adafruit/Adafruit-Circuit-Playground-Tri-Color-E-Ink-Gizmo-PCB/Circuit Playground Tri-color E-Ink Gizmo.brd

## EAGLE design Circuit Playground Tri-color E-Ink Gizmo.brd (2019-11-20)

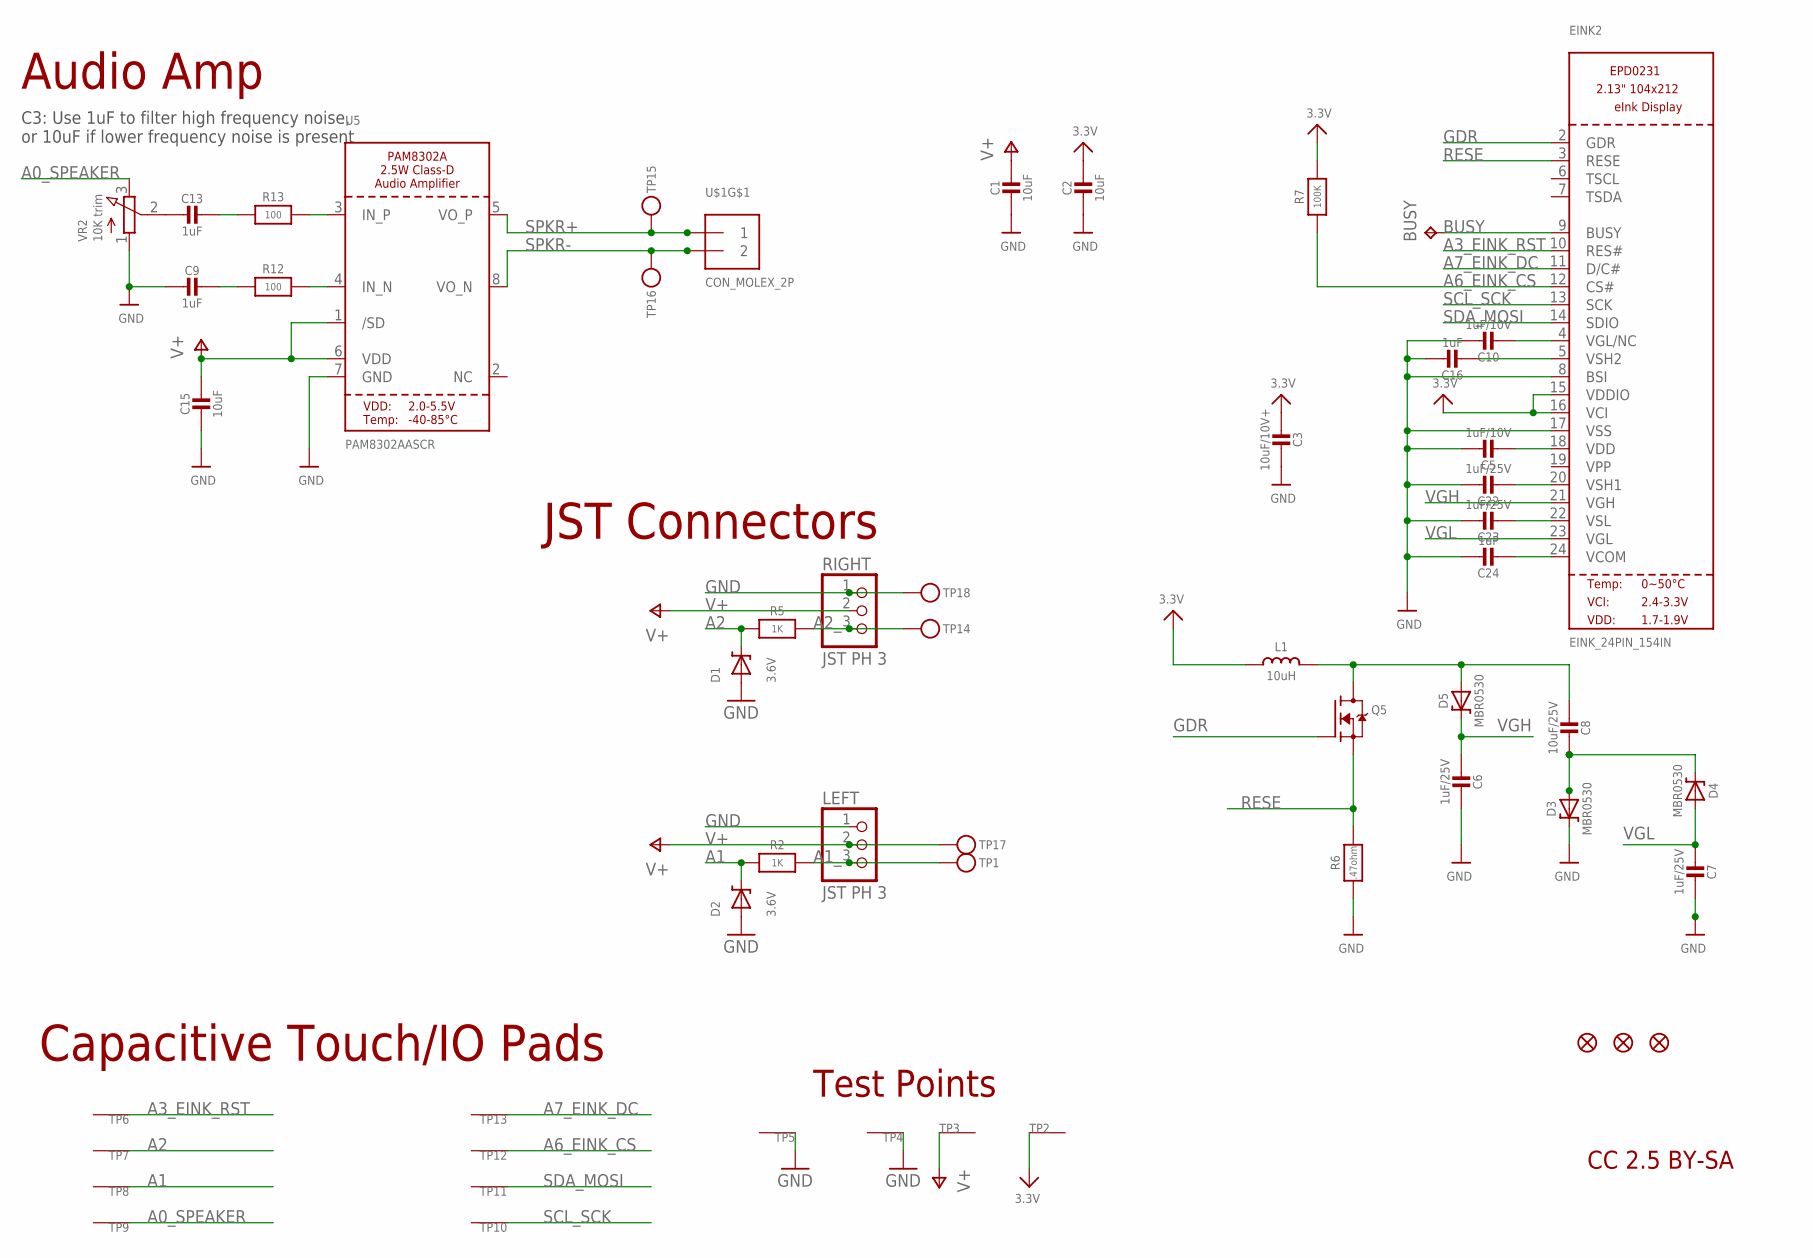
[picture p2: schematic Circuit Playground Tri-color E-Ink Gizmo.sch]

Parts:
BUSY: TPTP15SQ; TP15SQ
C1, C2, C15: 10uF; 0805-NO
C3: 10uF/10V+; 0805-NO
C5, C10: 1uF/10V; 0805-NO
C6, C7, C22, C23: 1uF/25V; 0805-NO
C8: 10uF/25V; 0805-NO
C9, C13, C16, C24: 1uF; 0805-NO
D1, D2: 3.6V; SOD-323
D3, D4, D5: MBR0530; SOD-123
EINK2: EINK_24PIN_154IN; EINK_154IN
L1: 10uH; INDUCTOR_4X4MM_NR401
LEFT: JST PH 3; JSTPH3
Q5: IRLML0100; SOT23-3
R2, R5: 1K; 0603-NO
R6: .47ohm; 0805_10MGAP
R7: 100K; 0603-NO
R12, R13: 100; 0603-NO
RIGHT: JST PH 3; JSTPH3
TP1, TP14, TP15, TP16, TP17, TP18: TESTPOINTROUND1.5MMNO; TESTPOINT_ROUND_1.5MM_NO
TP2, TP3, TP4, TP5, TP6, TP7, TP8, TP9, TP10, TP11, TP12, TP13: SEWTAP_SMTNUTM3; SMT_NUT_3MM
U5: PAM8302AASCR; MSOP8_0.65MM
U$1: CON_MOLEX_2P; 53398-0271
U$2, U$3, U$6: FIDUCIAL_1MM
VR2: 10K trim; TRIMPOT_BOURNS_3303W

Connections:
3.3V: C2.1, C3.2, EINK2.15 (VDDIO), EINK2.16 (VCI), L1.P$2 (2), R7.2, TP2.P$1
A0_SPEAKER: TP9.P$1, VR2.3 (E)
A1: D2.C, R2.2, TP8.P$1
A1_: LEFT.3, R2.1, TP1.P$1
A2: D1.C, R5.2, TP7.P$1
A2_: R5.1, RIGHT.3, TP14.P$1
A3_EINK_RST: EINK2.10 (RES#), TP6.P$1
A6_EINK_CS: EINK2.12 (CS#), R7.1, TP12.P$1
A7_EINK_DC: EINK2.11 (D/C#), TP13.P$1
BUSY: BUSY.TP, EINK2.9 (BUSY)
GDR: EINK2.2 (GDR), Q5.1 (G)
GND: C1.2, C2.2, C3.1, C5.1, C6.2, C7.2, C9.2, C10.1, C15.2, C16.1, C22.1, C23.1, C24.1, D1.A, D2.A, D3.C, EINK2.8 (BSI), EINK2.17 (VSS), LEFT.1, R6.2, RIGHT.1, TP4.P$1, TP5.P$1, TP18.P$1, U5.7 (GND), VR2.1 (A)
unnamed: C8.2, D3.A, D4.C
unnamed: C8.1, D5.A, L1.P$1 (1), Q5.3 (D)
unnamed: C16.2, EINK2.5 (VSH2)
unnamed: C5.2, EINK2.18 (VDD)
unnamed: C22.2, EINK2.20 (VSH1)
unnamed: C10.2, EINK2.4 (VGL/NC)
unnamed: R12.2, U5.4 (IN_N)
unnamed: R13.2, U5.3 (IN_P)
unnamed: C9.1, R12.1
unnamed: C13.1, R13.1
unnamed: C13.2, VR2.2 (S)
unnamed: C23.2, EINK2.22 (VSL)
unnamed: C24.2, EINK2.24 (VCOM)
RESE: EINK2.3 (RESE), Q5.2 (S), R6.1
SCL_SCK: EINK2.13 (SCK), TP10.P$1
SDA_MOSI: EINK2.14 (SDIO), TP11.P$1
SPKR+: TP15.P$1, U5.5 (VO_P), U$1.1
SPKR-: TP16.P$1, U5.8 (VO_N), U$1.2
V+: C1.1, C15.1, LEFT.2, RIGHT.2, TP3.P$1, TP17.P$1, U5.1 (/SD), U5.6 (VDD)
VGH: C6.1, D5.C, EINK2.21 (VGH)
VGL: C7.1, D4.A, EINK2.23 (VGL)

Notes on the sheet:
CC 2.5 BY-SA
Capacitive Touch/IO Pads
C3: Use 1uF to filter high frequency noise, or 10uF if lower frequency noise is present
Audio Amp
Test Points
JST Connectors

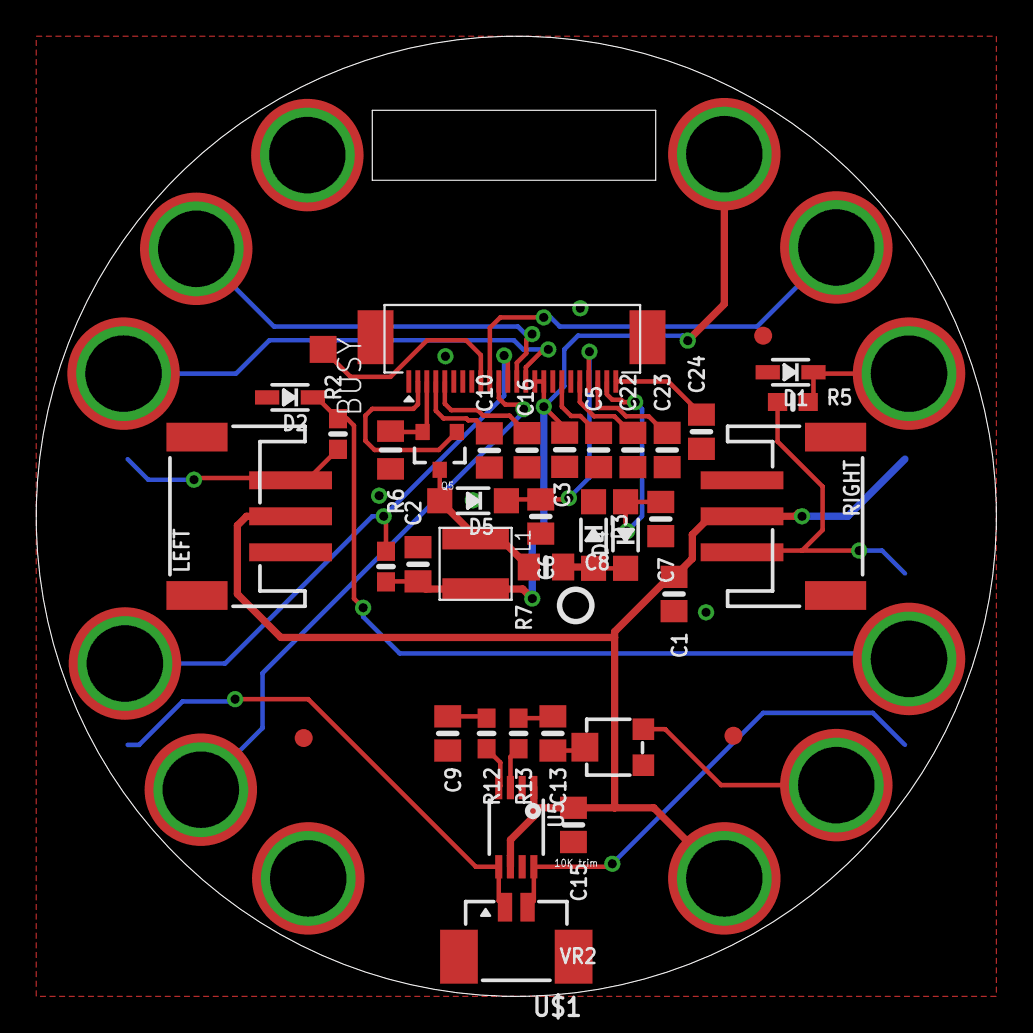
[picture p3: board Circuit Playground Tri-color E-Ink Gizmo.brd from above]

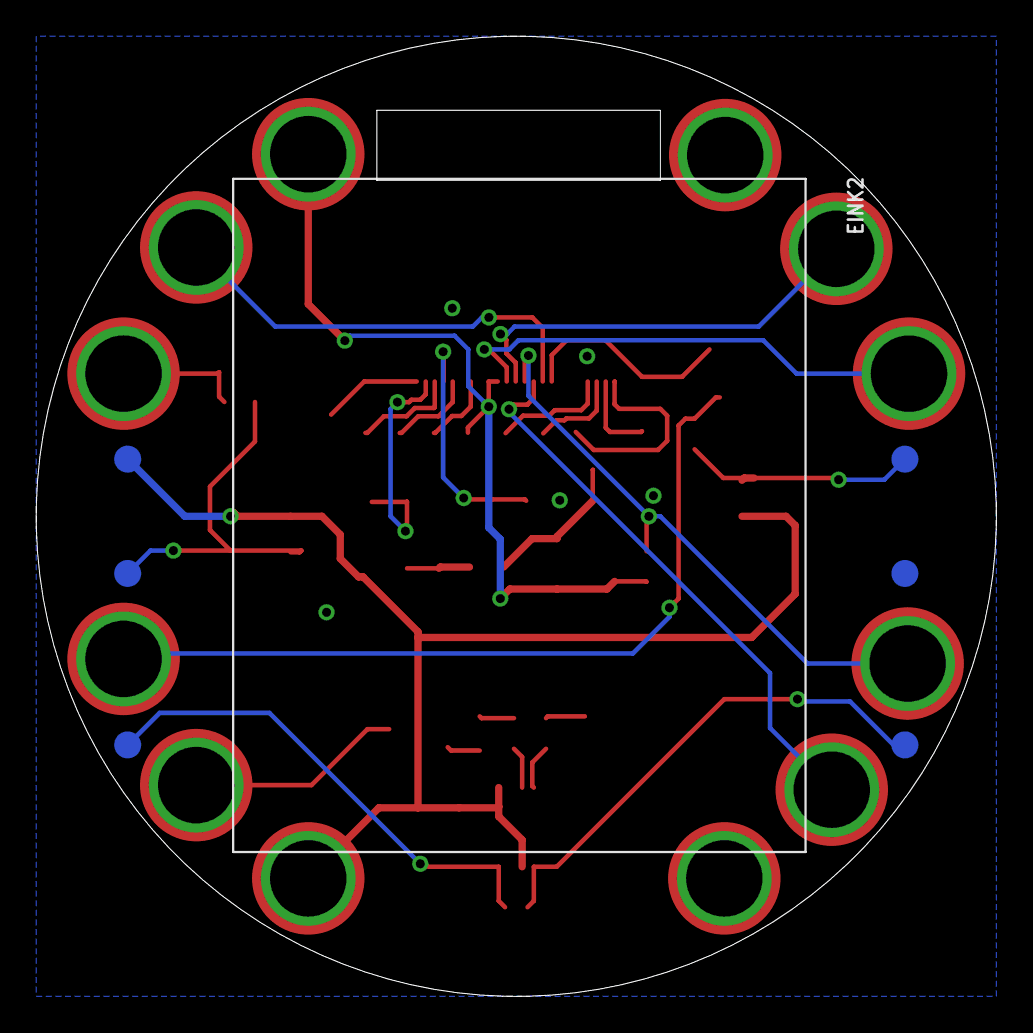
[picture p4: board Circuit Playground Tri-color E-Ink Gizmo.brd from below]

Board: 2 copper layers, 53.3 x 53.3 mm, 59 parts (8 on the bottom side), 33 nets.

Other parts of the board:
U$4: EINKGIZMO_BACK
U$7: PCBFEAT-REV-040
U$8: EINKGIZMO_FRONT
